siul72/telluino-hb/telluino-hb-kicad/case/telluino_case-Partbox_lid.stl

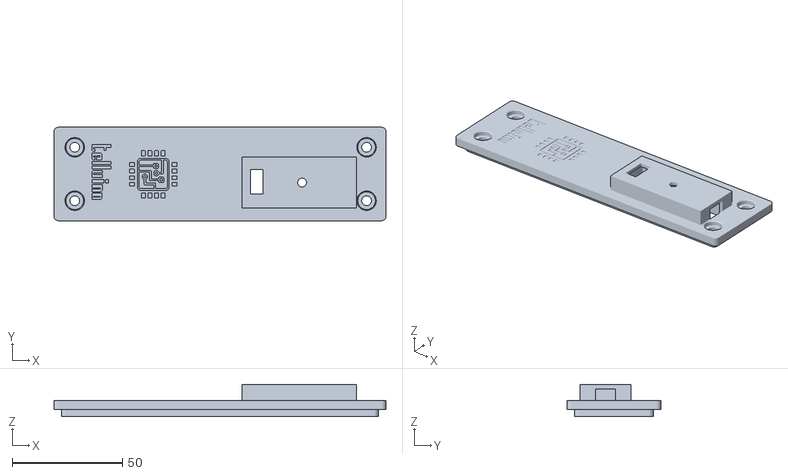
[picture p1: CAD file, 2023-12-17]
telluino-hb-kicad/case/telluino_case-Partbox_lid.stl
150.4 x 42.4 x 14.5
