siul72/telluino-hb/telluino-hb-kicad/case/telluino_case.FCStd

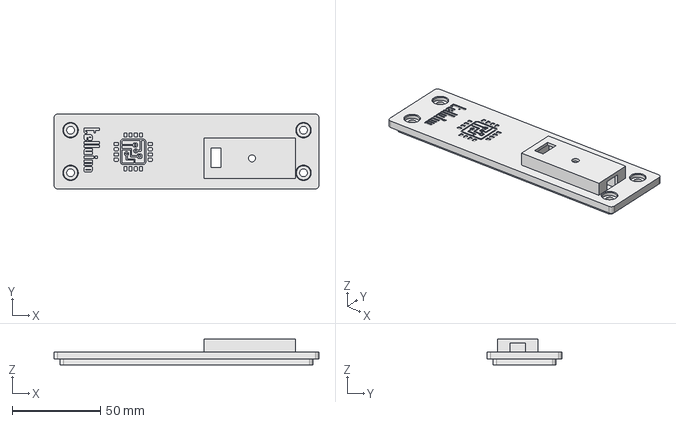
[picture p2: CAD file, 2023-12-17]
telluino-hb-kicad/case/telluino_case.FCStd
150.4 x 42.4 x 14.5 mm
