siul72/telluino-hb/telluino-hb-kicad/case/telluino_case-Partbox.stl

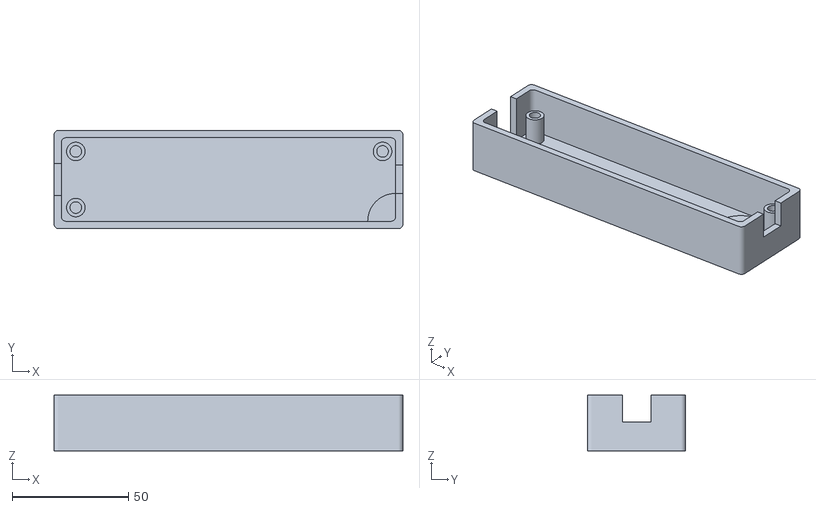
[picture p3: CAD file, 2023-12-17]
telluino-hb-kicad/case/telluino_case-Partbox.stl
150.4 x 42.4 x 24.0
