siul72/telluino-hb/telluino-hb-kicad/case/telluino_case-PartBody002.stl

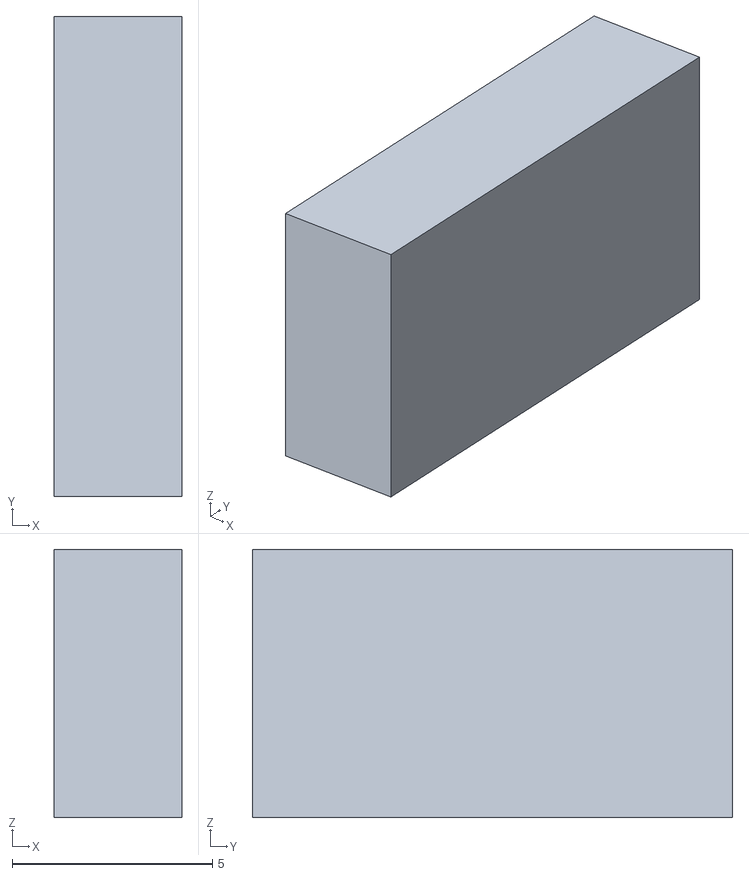
[picture p4: CAD file, 2023-12-17]
telluino-hb-kicad/case/telluino_case-PartBody002.stl
3.20 x 12.0 x 6.70
