siul72/telluino-hb/telluino-hb-kicad/case/telluino_case-PartBody003.stl

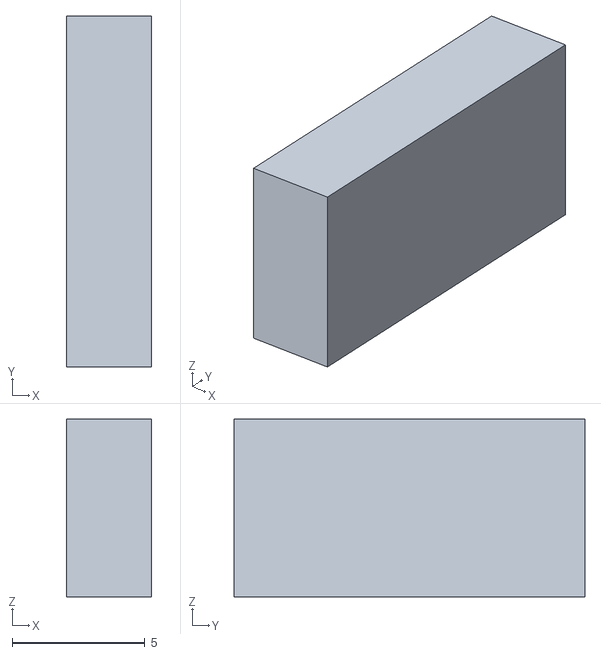
[picture p5: CAD file, 2023-12-17]
telluino-hb-kicad/case/telluino_case-PartBody003.stl
3.20 x 13.2 x 6.70
