siul72/telluino-hb/telluino-hb-kicad/telluino.kicad_pcb

## KiCad design telluino-hb-kicad/telluino.kicad_pcb (2023-12-03)

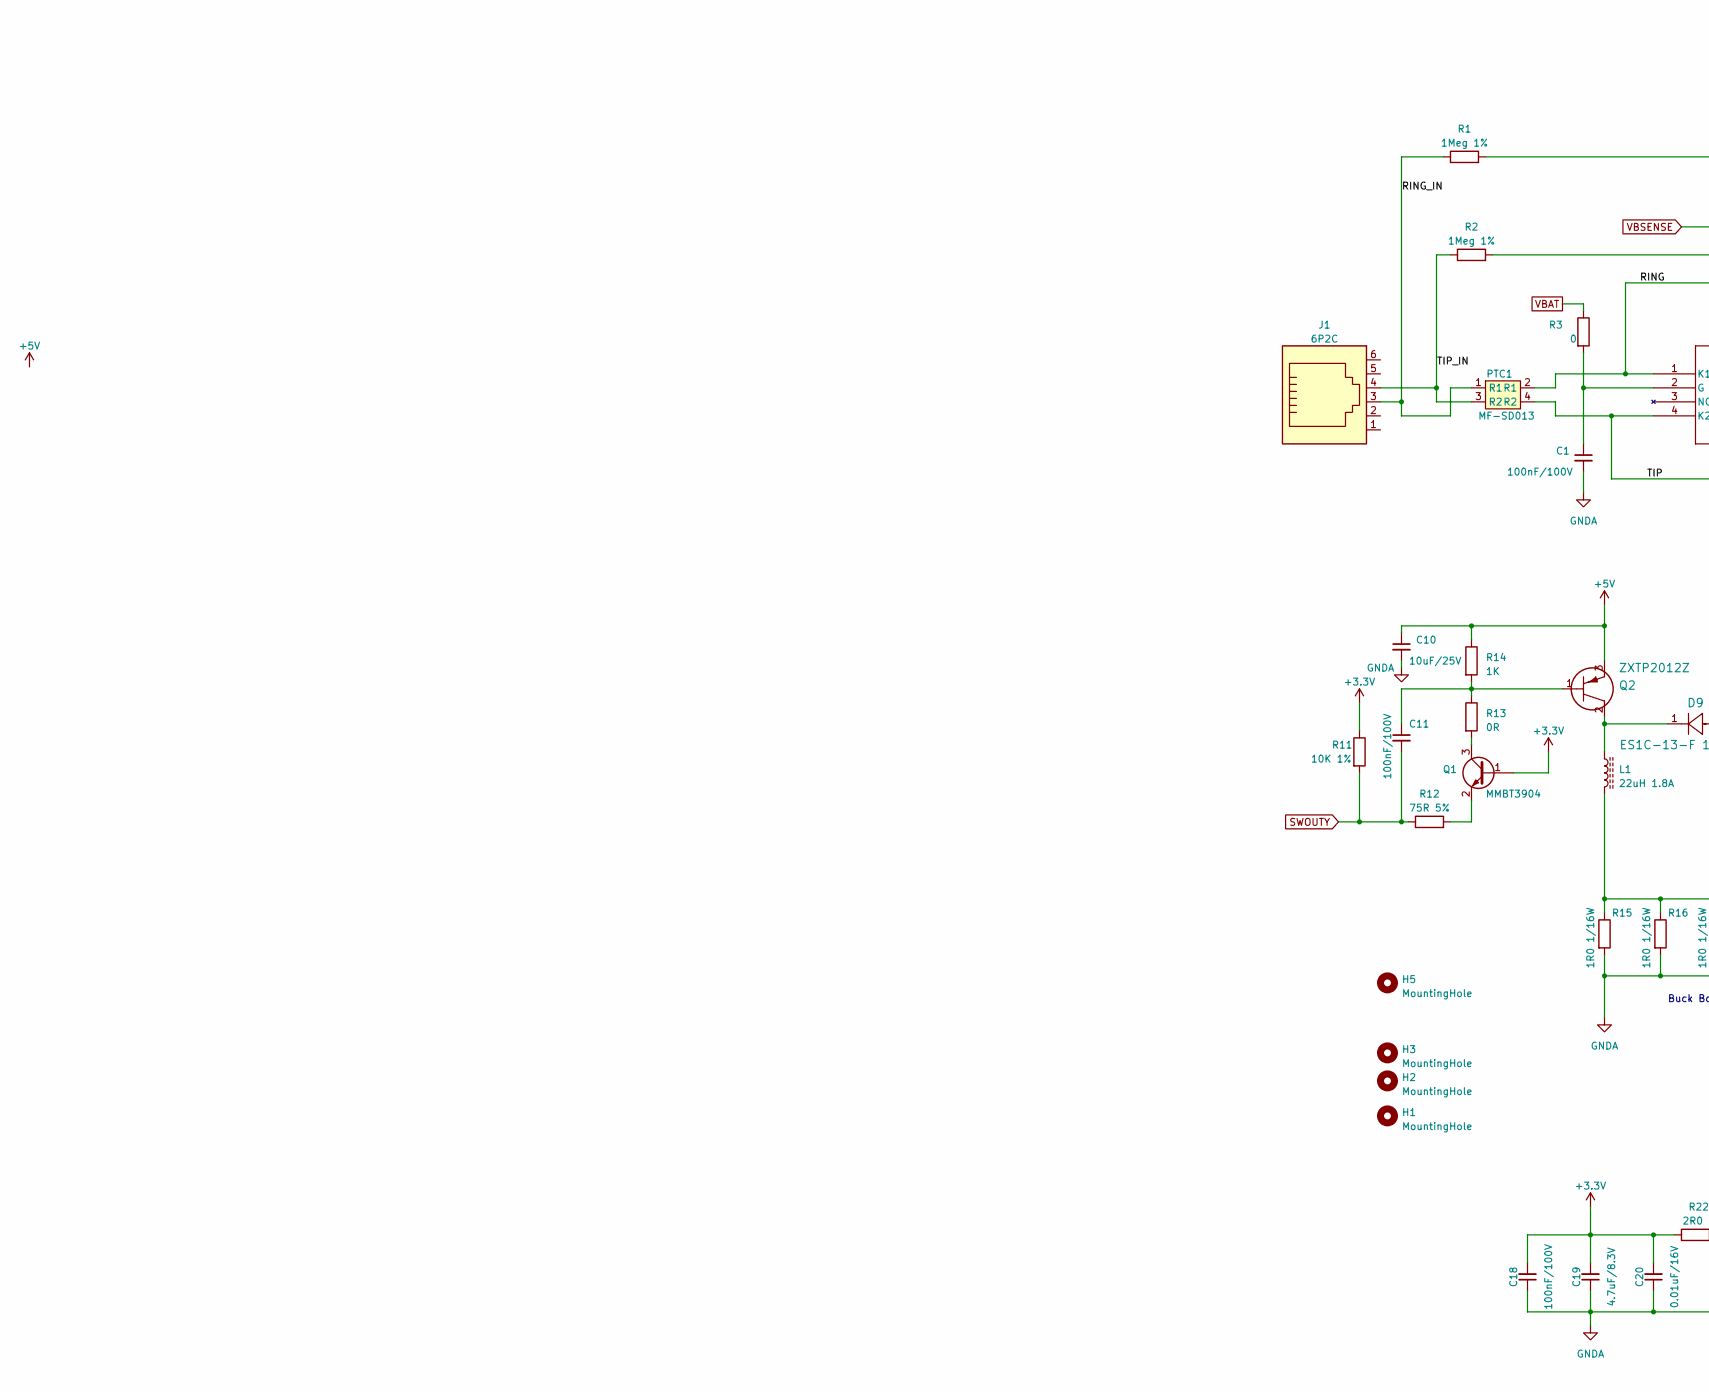
[picture p6: schematic telluino.kicad_sch, Telluino Uno Schield, part in row 1, column 1]

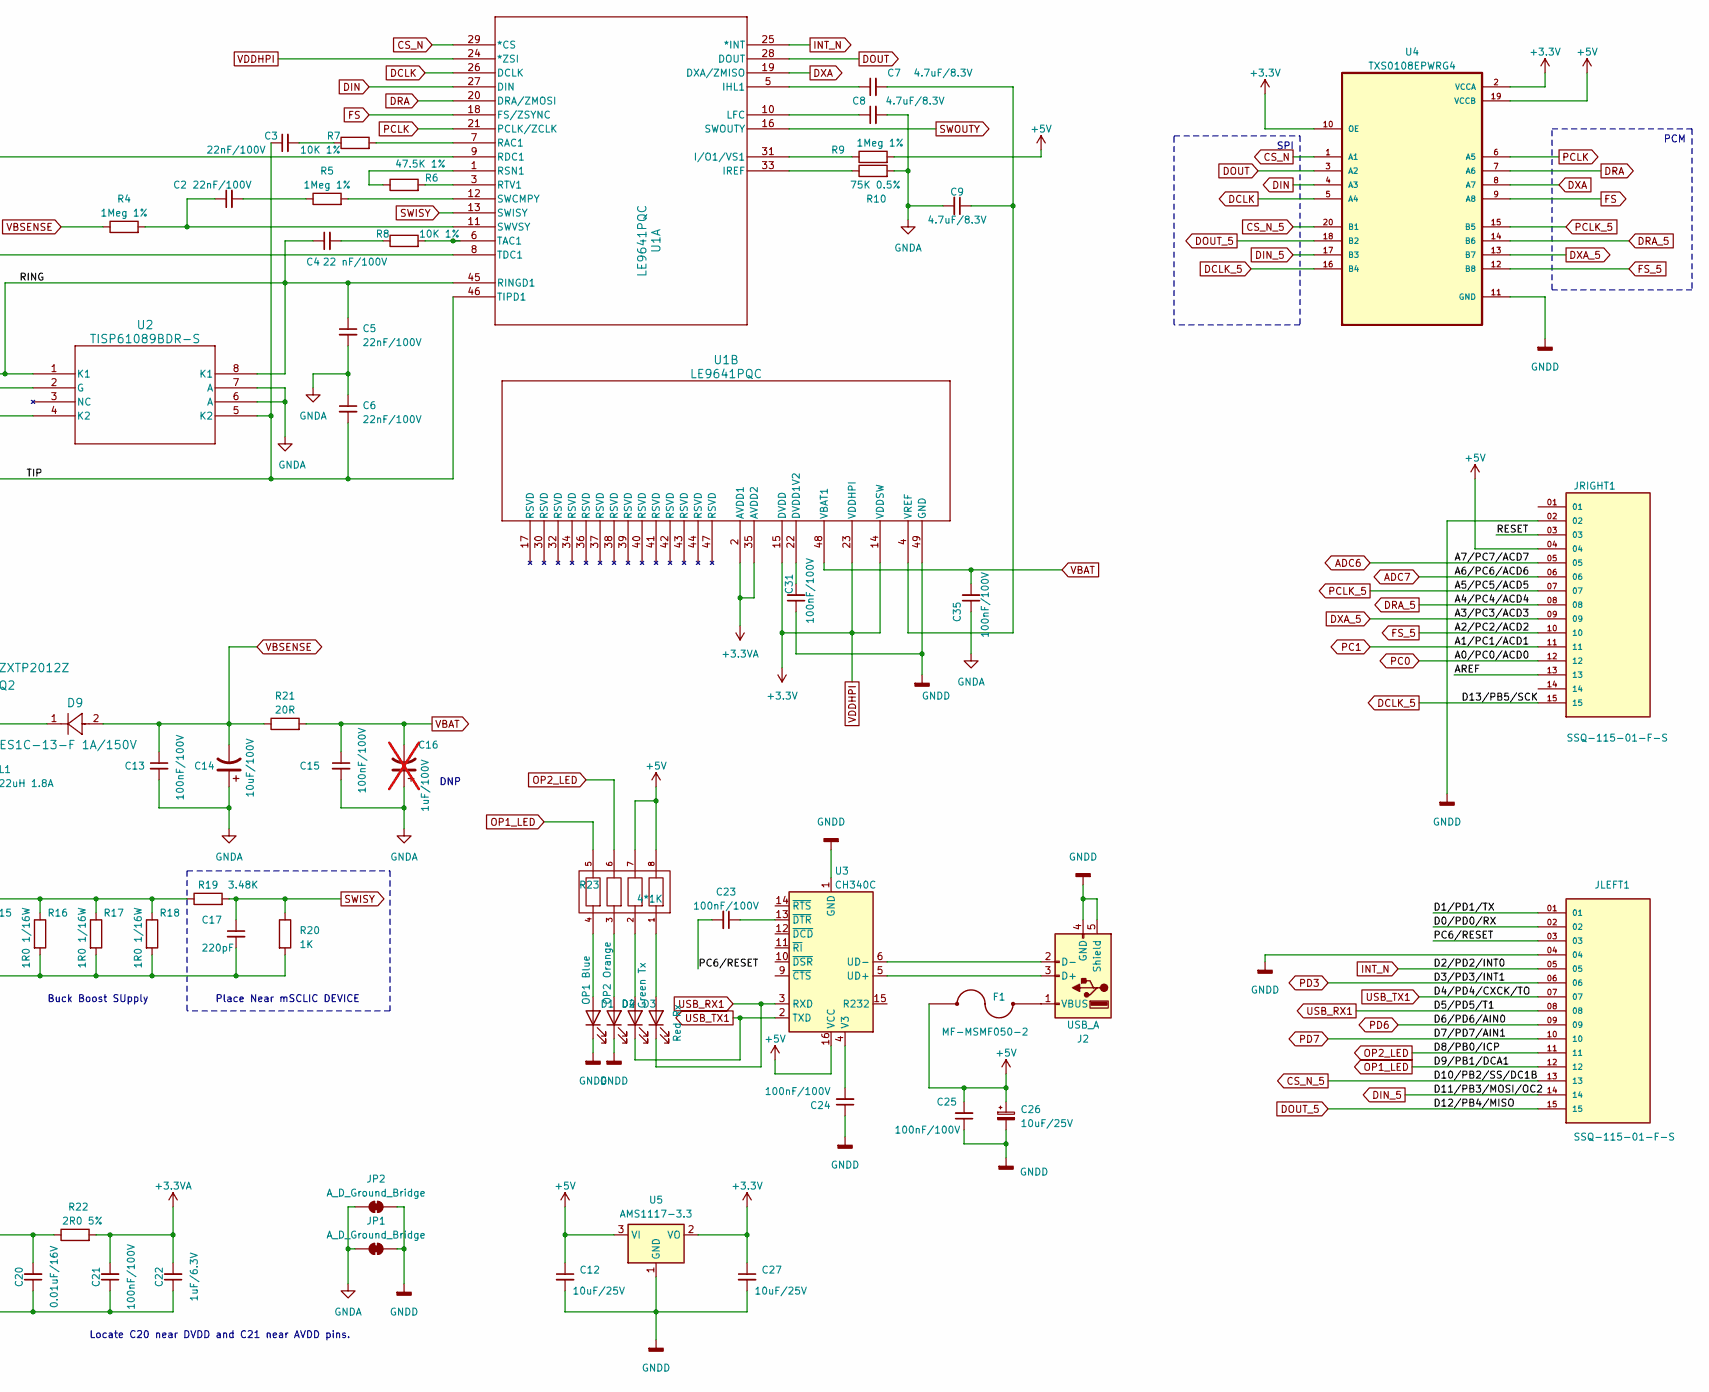
[picture p7: schematic telluino.kicad_sch, Telluino Uno Schield, part in row 1, column 2]

Parts:
C1, C11, C13, C15, C18, C21, C23, C24, C25, C31, C35: 100nF/100V; C_0603_1608Metric
C2, C3, C5, C6: 22nF/100V; C_0603_1608Metric
C4: 22 nF/100V; C_0603_1608Metric
C7, C8, C9, C19: 4.7uF/8.3V; C_0603_1608Metric
C10, C12, C27: 10uF/25V; C_0603_1608Metric
C14: 10uF/100V; CP_Radial_D8.0mm_P3.50mm
C16: 1uF/100V; CP_Radial_D8.0mm_P3.50mm; not fitted
C17: 220pF; C_0603_1608Metric
C20: 0.01uF/16V; C_0603_1608Metric
C22: 1uF/6.3V; C_0603_1608Metric
C26: 10uF/25V; CP_Radial_D5.0mm_P2.50mm
D1: OP1 Blue; LED_0603_1608Metric
D2: OP2 Orange; LED_0603_1608Metric
D3: Red Rx; LED_0603_1608Metric
D4: Green Tx; LED_0603_1608Metric
D9: ES1C-13-F 1A/150V; D_SMA
F1: MF-MSMF050-2; FUSM4632X85
H1, H2, H3: MountingHole; MountingHole_4.3mm_M4
H5: MountingHole; MountingHole_2.2mm_M2
J1: 6P2C; RJ12_Amphenol_54601
J2: USB_A; USB_A_CNCTech_1001-011-01101_Horizontal
JLEFT1: SSQ-115-01-F-S; SAMTEC_SSQ-115-01-F-S; PARTREV R
JP1, JP2: A_D_Ground_Bridge; SolderJumper-2_P1.3mm_Bridged_RoundedPad1.0x1.5mm
JRIGHT1: SSQ-115-01-F-S; SAMTEC_SSQ-115-01-F-S; PARTREV R
L1: 22uH 1.8A; L_10.4x10.4_H4.8
PTC1: MF-SD013; ptc-4-mf-sd
Q1: MMBT3904; SOT-23
Q2: ZXTP2012Z; SOT-89-3_4P5X2P6_DIO
R1, R2, R4, R5, R9: 1Meg 1%; R_0603_1608Metric
R3: 0; R_0603_1608Metric
R6: 47.5K 1%; R_0603_1608Metric
R7, R8, R11: 10K 1%; R_0603_1608Metric
R10: 75K 0.5%; R_0603_1608Metric
R12: 75R 5%; R_0603_1608Metric
R13: 0R; R_0603_1608Metric
R14: 1K; R_0603_1608Metric
R15, R16, R17, R18: 1R0 1/16W; R_0402_1005Metric
R19: 3.48K; R_0402_1005Metric
R20: 1K; R_0402_1005Metric
R21: 20R; R_1206_3216Metric
R22: 2R0 5%; R_0603_1608Metric
R23: 4*1K; RESCAXE80P320X160X70-8N; PARTREV 0
U1: LE9641PQC; QFN50P700X700X90-49N
U2: TISP61089BDR-S; SOIC127P780X210-8N
U3: CH340C; SOIC-16_3.9x9.9mm_P1.27mm
U4: TXS0108EPWRG4; SOP65P640X120-20N
U5: AMS1117-3.3; SOT-223-3_TabPin2

Connections:
+3.3VA: C21.2, C22.2, R22.2, U1.2 (AVDD1), U1.35 (AVDD2)
+3.3VP: C24.2, U3.4 (V3); also elsewhere on the board
+3V3: JRIGHT1.14; also elsewhere on the board
/AREF: JRIGHT1.13
/D0/PD0/RX: JLEFT1.02
/D1/PD1/TX: JLEFT1.01
/PC6/RESET: C23.2, JLEFT1.03
/RESET: JRIGHT1.03
/RING: C4.1, C5.1, PTC1.2 (R1), U1.45 (RINGD1), U2.1 (K1), U2.8 (K1)
/RING_IN: J1.3, PTC1.1 (R1), R1.1
/TIP: C3.1, C6.2, PTC1.4 (R2), U1.46 (TIPD1), U2.4 (K2), U2.5 (K2)
/TIP_IN: J1.4, PTC1.3 (R2), R2.1
ADC6: JRIGHT1.05
ADC7: JRIGHT1.06
CS_N: U1.29 (*CS), U4.1 (A1)
CS_N_5: JLEFT1.13, U4.20 (B1)
DCLK: U1.26 (DCLK), U4.5 (A4)
DCLK_5: JRIGHT1.15, U4.16 (B4)
DIN: U1.27 (DIN), U4.4 (A3)
DIN_5: JLEFT1.14, U4.17 (B3)
DOUT: U1.28 (DOUT), U4.3 (A2)
DOUT_5: JLEFT1.15, U4.18 (B2)
DRA: U1.20 (DRA/ZMOSI), U4.7 (A6)
DRA_5: JRIGHT1.08, U4.14 (B6)
DXA: U1.19 (DXA/ZMISO), U4.8 (A7)
DXA_5: JRIGHT1.09, U4.13 (B7)
FS: U1.18 (FS/ZSYNC), U4.9 (A8)
FS_5: JRIGHT1.10, U4.12 (B8)
GNDA: C1.2, C5.2, C6.1, C8.2, C9.2, C10.2, C13.2, C14.1, C15.2, C16.1, C17.2, C18.1, C19.1, C20.1, C21.1, C22.1, C35.1, JP1.1 (A), JP2.1 (A), R10.2, R15.2, R16.2, R17.2, R18.2, R20.2, U2.6 (A), U2.7 (A)
GNDD: C12.2, C24.1, C25.1, C26.2, C27.2, C31.1, D1.1 (K), D2.1 (K), J2.4 (GND), J2.5 (Shield), JLEFT1.04, JP1.2 (B), JP2.2 (B), JRIGHT1.02, U1.49 (GND), U3.1 (GND), U4.11 (GND), U5.1 (GND)
INT_N: JLEFT1.05, U1.25 (*INT)
unnamed: C2.2, R5.1
unnamed: C3.2, R7.1
unnamed: C4.2, R8.1
unnamed 34: C11.1, Q2.1, R13.1, R14.2; also elsewhere on the board
unnamed: D1.2 (A), R23.4
unnamed: D2.2 (A), R23.3
unnamed: D3.2 (A), R23.1
unnamed: D4.2 (A), R23.2
unnamed 39: D9.1, L1.1, Q2.2; also elsewhere on the board
unnamed: J2.3 (D+), U3.5 (UD+)
unnamed: J2.2 (D-), U3.6 (UD-)
unnamed: F1.1, J2.1 (VBUS)
unnamed: L1.2, R15.1, R16.1, R17.1, R18.1, R19.1
unnamed: Q1.3 (C), R13.2
unnamed: Q1.2 (E), R12.2
unnamed: C7.1, U1.5 (IHL1)
unnamed: R10.1, U1.33 (IREF)
unnamed: R9.1, U1.31 (I/O1/VS1)
unnamed: C8.1, U1.10 (LFC)
unnamed: R7.2, U1.7 (RAC1)
unnamed: R1.2, U1.9 (RDC1)
unnamed: R6.1, U1.1 (RSN1)
unnamed: R6.2, U1.3 (RTV1)
unnamed: R5.2, U1.12 (SWCMPY)
unnamed: C2.1, R4.2, U1.11 (SWVSY)
unnamed: R8.2, U1.6 (TAC1)
unnamed: R2.2, U1.8 (TDC1)
unnamed: C31.2, U1.22 (DVDD1V2)
unnamed: C7.2, C9.1, U1.4 (VREF)
unnamed: C1.1, R3.2, U2.2 (G)
unnamed: C23.1, U3.13 (~DTR)
OP1_LED: JLEFT1.12, R23.5
OP2_LED: JLEFT1.11, R23.6
PC0: JRIGHT1.12
PC1: JRIGHT1.11
PCLK: U1.21 (PCLK/ZCLK), U4.6 (A5)
PCLK_5: JRIGHT1.07, U4.15 (B5)
PD3: JLEFT1.06
PD6: JLEFT1.09
PD7: JLEFT1.10
SWISY: C17.1, R19.2, R20.1, U1.13 (SWISY)
SWOUTY: C11.2, R11.2, R12.1, U1.16 (SWOUTY)
USB_RX1: D3.1 (K), JLEFT1.08, U3.3 (RXD)
USB_TX1: D4.1 (K), JLEFT1.07, U3.2 (TXD)
VBAT: C15.1, C16.2, C35.2, R3.1, R21.2, U1.48 (VBAT1)
VBSENSE: C13.1, C14.2, D9.2, R4.1, R21.1
VDDHPI: C18.2, C19.2, C20.2, C27.1, Q1.1 (B), R11.1, R22.1, U1.14 (VDDSW), U1.15 (DVDD), U1.23 (VDDHPI), U1.24 (*ZSI), U4.2 (VCCA), U4.10 (OE), U5.2 (VO); also elsewhere on the board

Notes on the sheet:
PCM
SPI
DNP
Locate C20 near DVDD and C21 near AVDD pins.
Buck Boost SUpply
Place Near mSCLIC DEVICE

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
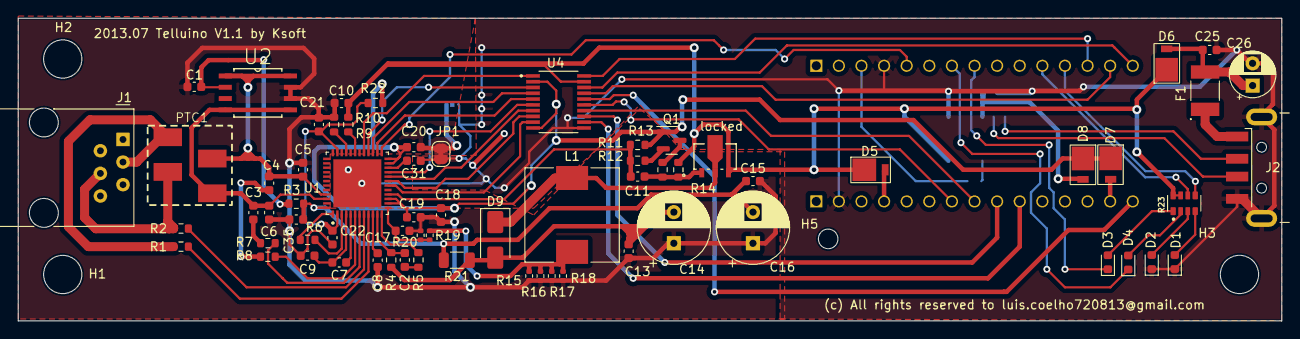
[picture p8: board telluino.kicad_pcb from above]

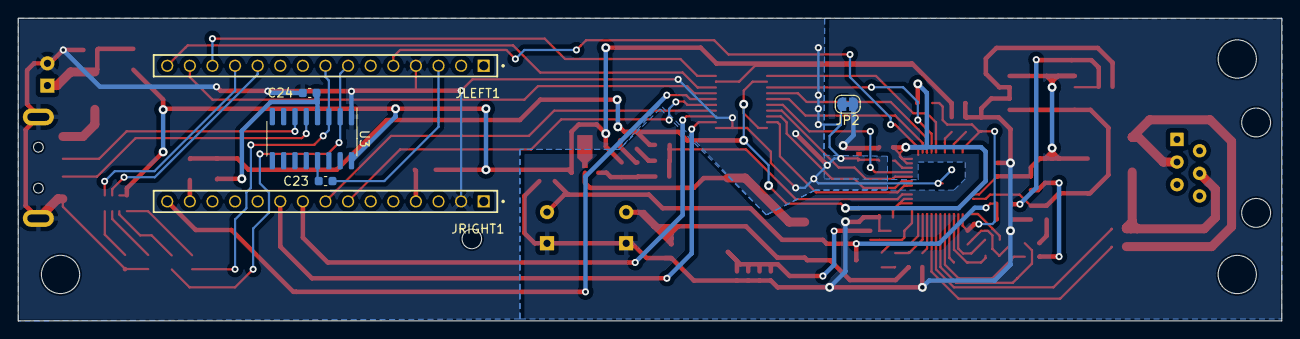
[picture p9: board telluino.kicad_pcb from below]

Board: 2 copper layers, 142.0 x 34.0 mm, 78 parts (6 on the bottom side), 70 nets.

Other parts of the board:
D5, D6, D7, D8: SS1P3L; DO220AAL
locked: ZXTP2012Z; SOT-89-3_4P5X2P6_DIO

Their connections:
+3.3VP: D8.2 (A); also elsewhere on the board
+3V3: D7.2 (A); also elsewhere on the board
unnamed 34: locked.1; also elsewhere on the board
unnamed 39: locked.2; also elsewhere on the board
VDDHPI: D7.1 (K), D8.1 (K); also elsewhere on the board
