siul72/telluino-hb/(commit log)

2023-06-11 placement done
    [telluino.kicad_pcb, telluino.kicad_sch]
2023-06-13 final board
    [telluino.kicad_pcb]
2023-06-15 small updates
    [telluino.csv, telluino.kicad_sch, telluino_out.ods]
2023-06-24 add case 3d drawings
    [telluino_case.FCStd]
2023-07-03 revision after bom review and schematic review
    U1 Pin 24 to connect to VCC
    Review components to make is more affordable
    [telluino.kicad_pcb, telluino.kicad_sch, telluino_out.ods]
2023-07-06 reworn resistor array
    [telluino.kicad_pcb, telluino.kicad_sch]
2023-08-25 update after first review
    [telluino.csv, telluino.kicad_pcb, telluino.kicad_sch, telluino_out.csv, telluino_out.ods]
2023-08-27 rework 3.3 power supply
    [telluino.kicad_sch]
2023-12-17 fix pocket
    [telluino_case-Partbox_lid.stl, telluino_case.FCStd]
