siul72/telluino-hb/(notices)

Notices in the files:
telluino-hb-kicad/telluino.kicad_pcb:
(c) All rights reserved to luis.coelho720813@gmail.com
